mattsroufe/esp32_rc_cars/(threads)

Thread 1 (2025-02-03):

Car chasis link is not valid

monksy, 2025-02-03:
The link 404s.

https://www.aliexpress.us/item/2251832644350656.html

markparnaby, 2025-02-03:
Works fine for me. Try searching for
`4WD RC Smart Car Chassis For Arduino Platform With MG996R Metal Gear Servo Bearing Kit Steering Gear Control DIY 4 Wheel Robot`
Should look like this

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

monksy, 2025-02-05:
Apparently it does not exist in the US market.

mattsroufe, 2025-02-05:
Thanks for that. Any chassis will do really and I don’t know if I’d use this one again. It’s not to scale and it’s pretty difficult to build and dial in the steering. It’s not especially cheap either compared to similar 1/16 - 1/24 rtr options out there. They often come with batteries and chargers too. Part of my goal though was to have something that was completely reusable for other projects.

Closed 2025-02-04.

Thread 2 (2025-02-03):

Please specify which brushed escs controller you need

monksy, 2025-02-03:
The Aliexpress listing shows one for 20a, and 30a.

mattsroufe, 2025-02-03:
I used the 30a one. The important part of the specification is the BEC - I opted the the 5v 3 amp output which you’ll need to power both the servo and esp32.

Closed 2025-02-04.

Thread 3 (2025-02-04):

Congrats

rizlas, 2025-02-04:
I opened this issue just to congratulate you. This reminded me of my and another colleague's high school project. Back in the days, there was less computing power or libraries available/usable. Check it out if you want: https://github.com/rizlas/Adventurino/tree/master

Maybe I'll use this to revive my old RC.

Bravo 👏🏻

mattsroufe, 2025-02-04:
Looks like a great project! Thanks for sharing.

Closed 2025-02-04.

Thread 4 (2025-03-06):

Advice on using socket.io and getting better FPS?

dtbaker, 2025-03-06:
Hey this is amazing. It inspired me to boot up my old robots again.

I have an existing socket.io backend that allows me to remote control these robots over the internet. They are all raspberry pi powered, but I'd like to get an ESP32-cam powered one into the mix.

I tweaked your code and got it connected to socket.io, however I'm only getting 4-5 FPS :( even with a locally running socket.io server.
It seems to take a very long time to send each jpeg frame to the socket.io backend.

Any advice on how possibly get more FPS out of this when talking to a socket.io based websocket server?

I'll keep trying a few things with socket.io, but if that fails I might just try a plain websocket backend to see if it's any faster.

Thanks for the code and inspiration!

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

dtbaker, 2025-03-06:
nice, I'm getting 50FPS running your python websocket server locally:

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

I'll rewrite the backend to support plain websockets and try again 🤞

mattsroufe, 2025-04-04:
Hi, glad to hear you got the project working. So is the framerate better now? The thing I ran into early on was the ESP32 board I was using did not have the 0 ohm resistor removed so it was using the internal antenna  instead of the external antenna.

dtbaker, 2025-04-04:
Oh interesting! I will investigate the antenna issue to see if that is also impacting me.

The ESP32 worked great, the next problem I had was the power source. My 18650's are a little old and would cause the ESP32 to reset when the servo activated for steering.

I'll try to fix that power issue this weekend and hook it up to the internet. (Keep an eye on [this website](https://www.controlmyrobot.com) to see when the "zoomie" car becomes available for remote control )
