mattsroufe/esp32_rc_cars/(commit log)

2024-12-18 add arduino code
2025-01-17 switch to esc
2025-01-25 refactor servo
2025-01-31 add frames
2025-08-29 Refactor web server (#7)
    * Update web_socket_server.py
    * Update web_socket_server.py
    * swith to bluetooth
    * Update bluetooth_control.h
    * Create SteeringServo.cpp
    * Create SteeringServo.h
    * add config
    * Update web_socket_server.py
    * shutdown gracefully
    * Update web_socket_server.py
    * Update web_socket_server.py
    * Update web_socket_server.py
    * Update web_socket_server.py
    * Update web_socket_server.py
    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
2025-10-26 use thread pool
